Madnessvia/LumiSync/hw/hw.ip_user_files/bd/hdmi/ip/hdmi_auto_rs_w_0/hdmi_auto_rs_w_0_sim_netlist.v

// Copyright 1986-2020 Xilinx, Inc. All Rights Reserved.
// --------------------------------------------------------------------------------
// Tool Version: Vivado v.2020.1 (win64) Build 2902540 Wed May 27 19:54:49 MDT 2020
// Date        : Sun Mar  9 00:44:12 2025
// Host        : DESKTOP-E9C4J7R running 64-bit major release  (build 9200)
// Command     : write_verilog -force -mode funcsim -rename_top hdmi_auto_rs_w_0 -prefix
//               hdmi_auto_rs_w_0_ hdmi_auto_rs_w_0_sim_netlist.v
// Design      : hdmi_auto_rs_w_0
// Purpose     : This verilog netlist is a functional simulation representation of the design and should not be modified
//               or synthesized. This netlist cannot be used for SDF annotated simulation.
// Device      : xc7a200tsbg484-1
// --------------------------------------------------------------------------------
`timescale 1 ps / 1 ps

(* C_AXI_ADDR_WIDTH = "29" *) (* C_AXI_ARUSER_WIDTH = "1" *) (* C_AXI_AWUSER_WIDTH = "1" *) 
(* C_AXI_BUSER_WIDTH = "1" *) (* C_AXI_DATA_WIDTH = "256" *) (* C_AXI_ID_WIDTH = "2" *) 
(* C_AXI_PROTOCOL = "0" *) (* C_AXI_RUSER_WIDTH = "1" *) (* C_AXI_SUPPORTS_REGION_SIGNALS = "1" *) 
(* C_AXI_SUPPORTS_USER_SIGNALS = "0" *) (* C_AXI_WUSER_WIDTH = "1" *) (* C_FAMILY = "artix7" *) 
(* C_NUM_SLR_CROSSINGS = "0" *) (* C_PIPELINES_MASTER_AR = "0" *) (* C_PIPELINES_MASTER_AW = "0" *) 
(* C_PIPELINES_MASTER_B = "0" *) (* C_PIPELINES_MASTER_R = "0" *) (* C_PIPELINES_MASTER_W = "0" *) 
(* C_PIPELINES_MIDDLE_AR = "0" *) (* C_PIPELINES_MIDDLE_AW = "0" *) (* C_PIPELINES_MIDDLE_B = "0" *) 
(* C_PIPELINES_MIDDLE_R = "0" *) (* C_PIPELINES_MIDDLE_W = "0" *) (* C_PIPELINES_SLAVE_AR = "0" *) 
(* C_PIPELINES_SLAVE_AW = "0" *) (* C_PIPELINES_SLAVE_B = "0" *) (* C_PIPELINES_SLAVE_R = "0" *) 
(* C_PIPELINES_SLAVE_W = "0" *) (* C_REG_CONFIG_AR = "0" *) (* C_REG_CONFIG_AW = "0" *) 
(* C_REG_CONFIG_B = "0" *) (* C_REG_CONFIG_R = "0" *) (* C_REG_CONFIG_W = "1" *) 
(* C_RESERVE_MODE = "0" *) (* DowngradeIPIdentifiedWarnings = "yes" *) (* G_AXI_ARADDR_INDEX = "0" *) 
(* G_AXI_ARADDR_WIDTH = "29" *) (* G_AXI_ARBURST_INDEX = "35" *) (* G_AXI_ARBURST_WIDTH = "2" *) 
(* G_AXI_ARCACHE_INDEX = "37" *) (* G_AXI_ARCACHE_WIDTH = "4" *) (* G_AXI_ARID_INDEX = "50" *) 
(* G_AXI_ARID_WIDTH = "2" *) (* G_AXI_ARLEN_INDEX = "41" *) (* G_AXI_ARLEN_WIDTH = "8" *) 
(* G_AXI_ARLOCK_INDEX = "49" *) (* G_AXI_ARLOCK_WIDTH = "1" *) (* G_AXI_ARPAYLOAD_WIDTH = "60" *) 
(* G_AXI_ARPROT_INDEX = "29" *) (* G_AXI_ARPROT_WIDTH = "3" *) (* G_AXI_ARQOS_INDEX = "52" *) 
(* G_AXI_ARQOS_WIDTH = "4" *) (* G_AXI_ARREGION_INDEX = "56" *) (* G_AXI_ARREGION_WIDTH = "4" *) 
(* G_AXI_ARSIZE_INDEX = "32" *) (* G_AXI_ARSIZE_WIDTH = "3" *) (* G_AXI_ARUSER_INDEX = "60" *) 
(* G_AXI_ARUSER_WIDTH = "0" *) (* G_AXI_AWADDR_INDEX = "0" *) (* G_AXI_AWADDR_WIDTH = "29" *) 
(* G_AXI_AWBURST_INDEX = "35" *) (* G_AXI_AWBURST_WIDTH = "2" *) (* G_AXI_AWCACHE_INDEX = "37" *) 
(* G_AXI_AWCACHE_WIDTH = "4" *) (* G_AXI_AWID_INDEX = "50" *) (* G_AXI_AWID_WIDTH = "2" *) 
(* G_AXI_AWLEN_INDEX = "41" *) (* G_AXI_AWLEN_WIDTH = "8" *) (* G_AXI_AWLOCK_INDEX = "49" *) 
(* G_AXI_AWLOCK_WIDTH = "1" *) (* G_AXI_AWPAYLOAD_WIDTH = "60" *) (* G_AXI_AWPROT_INDEX = "29" *) 
(* G_AXI_AWPROT_WIDTH = "3" *) (* G_AXI_AWQOS_INDEX = "52" *) (* G_AXI_AWQOS_WIDTH = "4" *) 
(* G_AXI_AWREGION_INDEX = "56" *) (* G_AXI_AWREGION_WIDTH = "4" *) (* G_AXI_AWSIZE_INDEX = "32" *) 
(* G_AXI_AWSIZE_WIDTH = "3" *) (* G_AXI_AWUSER_INDEX = "60" *) (* G_AXI_AWUSER_WIDTH = "0" *) 
(* G_AXI_BID_INDEX = "2" *) (* G_AXI_BID_WIDTH = "2" *) (* G_AXI_BPAYLOAD_WIDTH = "4" *) 
(* G_AXI_BRESP_INDEX = "0" *) (* G_AXI_BRESP_WIDTH = "2" *) (* G_AXI_BUSER_INDEX = "4" *) 
(* G_AXI_BUSER_WIDTH = "0" *) (* G_AXI_RDATA_INDEX = "0" *) (* G_AXI_RDATA_WIDTH = "256" *) 
(* G_AXI_RID_INDEX = "259" *) (* G_AXI_RID_WIDTH = "2" *) (* G_AXI_RLAST_INDEX = "258" *) 
(* G_AXI_RLAST_WIDTH = "1" *) (* G_AXI_RPAYLOAD_WIDTH = "261" *) (* G_AXI_RRESP_INDEX = "256" *) 
(* G_AXI_RRESP_WIDTH = "2" *) (* G_AXI_RUSER_INDEX = "261" *) (* G_AXI_RUSER_WIDTH = "0" *) 
(* G_AXI_WDATA_INDEX = "0" *) (* G_AXI_WDATA_WIDTH = "256" *) (* G_AXI_WID_INDEX = "289" *) 
(* G_AXI_WID_WIDTH = "0" *) (* G_AXI_WLAST_INDEX = "288" *) (* G_AXI_WLAST_WIDTH = "1" *) 
(* G_AXI_WPAYLOAD_WIDTH = "289" *) (* G_AXI_WSTRB_INDEX = "256" *) (* G_AXI_WSTRB_WIDTH = "32" *) 
(* G_AXI_WUSER_INDEX = "289" *) (* G_AXI_WUSER_WIDTH = "0" *) (* P_FORWARD = "0" *) 
(* P_RESPONSE = "1" *) 
module hdmi_auto_rs_w_0_axi_register_slice_v2_1_21_axi_register_slice
   (aclk,
    aclk2x,
    aresetn,
    s_axi_awid,
    s_axi_awaddr,
    s_axi_awlen,
    s_axi_awsize,
    s_axi_awburst,
    s_axi_awlock,
    s_axi_awcache,
    s_axi_awprot,
    s_axi_awregion,
    s_axi_awqos,
    s_axi_awuser,
    s_axi_awvalid,
    s_axi_awready,
    s_axi_wid,
    s_axi_wdata,
    s_axi_wstrb,
    s_axi_wlast,
    s_axi_wuser,
    s_axi_wvalid,
    s_axi_wready,
    s_axi_bid,
    s_axi_bresp,
    s_axi_buser,
    s_axi_bvalid,
    s_axi_bready,
    s_axi_arid,
    s_axi_araddr,
    s_axi_arlen,
    s_axi_arsize,
    s_axi_arburst,
    s_axi_arlock,
    s_axi_arcache,
    s_axi_arprot,
    s_axi_arregion,
    s_axi_arqos,
    s_axi_aruser,
    s_axi_arvalid,
    s_axi_arready,
    s_axi_rid,
    s_axi_rdata,
    s_axi_rresp,
    s_axi_rlast,
    s_axi_ruser,
    s_axi_rvalid,
    s_axi_rready,
    m_axi_awid,
    m_axi_awaddr,
    m_axi_awlen,
    m_axi_awsize,
    m_axi_awburst,
    m_axi_awlock,
    m_axi_awcache,
    m_axi_awprot,
    m_axi_awregion,
    m_axi_awqos,
    m_axi_awuser,
    m_axi_awvalid,
    m_axi_awready,
    m_axi_wid,
    m_axi_wdata,
    m_axi_wstrb,
    m_axi_wlast,
    m_axi_wuser,
    m_axi_wvalid,
    m_axi_wready,
    m_axi_bid,
    m_axi_bresp,
    m_axi_buser,
    m_axi_bvalid,
    m_axi_bready,
    m_axi_arid,
    m_axi_araddr,
    m_axi_arlen,
    m_axi_arsize,
    m_axi_arburst,
    m_axi_arlock,
    m_axi_arcache,
    m_axi_arprot,
    m_axi_arregion,
    m_axi_arqos,
    m_axi_aruser,
    m_axi_arvalid,
    m_axi_arready,
    m_axi_rid,
    m_axi_rdata,
    m_axi_rresp,
    m_axi_rlast,
    m_axi_ruser,
    m_axi_rvalid,
    m_axi_rready);
  input aclk;
  input aclk2x;
  input aresetn;
  input [1:0]s_axi_awid;
  input [28:0]s_axi_awaddr;
  input [7:0]s_axi_awlen;
  input [2:0]s_axi_awsize;
  input [1:0]s_axi_awburst;
  input [0:0]s_axi_awlock;
  input [3:0]s_axi_awcache;
  input [2:0]s_axi_awprot;
  input [3:0]s_axi_awregion;
  input [3:0]s_axi_awqos;
  input [0:0]s_axi_awuser;
  input s_axi_awvalid;
  output s_axi_awready;
  input [1:0]s_axi_wid;
  input [255:0]s_axi_wdata;
  input [31:0]s_axi_wstrb;
  input s_axi_wlast;
  input [0:0]s_axi_wuser;
  input s_axi_wvalid;
  output s_axi_wready;
  output [1:0]s_axi_bid;
  output [1:0]s_axi_bresp;
  output [0:0]s_axi_buser;
  output s_axi_bvalid;
  input s_axi_bready;
  input [1:0]s_axi_arid;
  input [28:0]s_axi_araddr;
  input [7:0]s_axi_arlen;
  input [2:0]s_axi_arsize;
  input [1:0]s_axi_arburst;
  input [0:0]s_axi_arlock;
  input [3:0]s_axi_arcache;
  input [2:0]s_axi_arprot;
  input [3:0]s_axi_arregion;
  input [3:0]s_axi_arqos;
  input [0:0]s_axi_aruser;
  input s_axi_arvalid;
  output s_axi_arready;
  output [1:0]s_axi_rid;
  output [255:0]s_axi_rdata;
  output [1:0]s_axi_rresp;
  output s_axi_rlast;
  output [0:0]s_axi_ruser;
  output s_axi_rvalid;
  input s_axi_rready;
  output [1:0]m_axi_awid;
  output [28:0]m_axi_awaddr;
  output [7:0]m_axi_awlen;
  output [2:0]m_axi_awsize;
  output [1:0]m_axi_awburst;
  output [0:0]m_axi_awlock;
  output [3:0]m_axi_awcache;
  output [2:0]m_axi_awprot;
  output [3:0]m_axi_awregion;
  output [3:0]m_axi_awqos;
  output [0:0]m_axi_awuser;
  output m_axi_awvalid;
  input m_axi_awready;
  output [1:0]m_axi_wid;
  output [255:0]m_axi_wdata;
  output [31:0]m_axi_wstrb;
  output m_axi_wlast;
  output [0:0]m_axi_wuser;
  output m_axi_wvalid;
  input m_axi_wready;
  input [1:0]m_axi_bid;
  input [1:0]m_axi_bresp;
  input [0:0]m_axi_buser;
  input m_axi_bvalid;
  output m_axi_bready;
  output [1:0]m_axi_arid;
  output [28:0]m_axi_araddr;
  output [7:0]m_axi_arlen;
  output [2:0]m_axi_arsize;
  output [1:0]m_axi_arburst;
  output [0:0]m_axi_arlock;
  output [3:0]m_axi_arcache;
  output [2:0]m_axi_arprot;
  output [3:0]m_axi_arregion;
  output [3:0]m_axi_arqos;
  output [0:0]m_axi_aruser;
  output m_axi_arvalid;
  input m_axi_arready;
  input [1:0]m_axi_rid;
  input [255:0]m_axi_rdata;
  input [1:0]m_axi_rresp;
  input m_axi_rlast;
  input [0:0]m_axi_ruser;
  input m_axi_rvalid;
  output m_axi_rready;

  wire \<const0> ;
  wire aclk;
  wire aresetn;
  wire m_axi_arready;
  wire m_axi_awready;
  wire [1:0]m_axi_bid;
  wire [1:0]m_axi_bresp;
  wire m_axi_bvalid;
  wire [255:0]m_axi_rdata;
  wire [1:0]m_axi_rid;
  wire m_axi_rlast;
  wire [1:0]m_axi_rresp;
  wire m_axi_rvalid;
  wire [255:0]m_axi_wdata;
  wire m_axi_wlast;
  wire m_axi_wready;
  wire [31:0]m_axi_wstrb;
  wire m_axi_wvalid;
  wire [28:0]s_axi_araddr;
  wire [1:0]s_axi_arburst;
  wire [3:0]s_axi_arcache;
  wire [1:0]s_axi_arid;
  wire [7:0]s_axi_arlen;
  wire [0:0]s_axi_arlock;
  wire [2:0]s_axi_arprot;
  wire [3:0]s_axi_arqos;
  wire [3:0]s_axi_arregion;
  wire [2:0]s_axi_arsize;
  wire s_axi_arvalid;
  wire [28:0]s_axi_awaddr;
  wire [1:0]s_axi_awburst;
  wire [3:0]s_axi_awcache;
  wire [1:0]s_axi_awid;
  wire [7:0]s_axi_awlen;
  wire [0:0]s_axi_awlock;
  wire [2:0]s_axi_awprot;
  wire [3:0]s_axi_awqos;
  wire [3:0]s_axi_awregion;
  wire [2:0]s_axi_awsize;
  wire s_axi_awvalid;
  wire s_axi_bready;
  wire s_axi_rready;
  wire [255:0]s_axi_wdata;
  wire s_axi_wlast;
  wire s_axi_wready;
  wire [31:0]s_axi_wstrb;
  wire s_axi_wvalid;

  assign m_axi_araddr[28:0] = s_axi_araddr;
  assign m_axi_arburst[1:0] = s_axi_arburst;
  assign m_axi_arcache[3:0] = s_axi_arcache;
  assign m_axi_arid[1:0] = s_axi_arid;
  assign m_axi_arlen[7:0] = s_axi_arlen;
  assign m_axi_arlock[0] = s_axi_arlock;
  assign m_axi_arprot[2:0] = s_axi_arprot;
  assign m_axi_arqos[3:0] = s_axi_arqos;
  assign m_axi_arregion[3:0] = s_axi_arregion;
  assign m_axi_arsize[2:0] = s_axi_arsize;
  assign m_axi_aruser[0] = \<const0> ;
  assign m_axi_arvalid = s_axi_arvalid;
  assign m_axi_awaddr[28:0] = s_axi_awaddr;
  assign m_axi_awburst[1:0] = s_axi_awburst;
  assign m_axi_awcache[3:0] = s_axi_awcache;
  assign m_axi_awid[1:0] = s_axi_awid;
  assign m_axi_awlen[7:0] = s_axi_awlen;
  assign m_axi_awlock[0] = s_axi_awlock;
  assign m_axi_awprot[2:0] = s_axi_awprot;
  assign m_axi_awqos[3:0] = s_axi_awqos;
  assign m_axi_awregion[3:0] = s_axi_awregion;
  assign m_axi_awsize[2:0] = s_axi_awsize;
  assign m_axi_awuser[0] = \<const0> ;
  assign m_axi_awvalid = s_axi_awvalid;
  assign m_axi_bready = s_axi_bready;
  assign m_axi_rready = s_axi_rready;
  assign m_axi_wid[1] = \<const0> ;
  assign m_axi_wid[0] = \<const0> ;
  assign m_axi_wuser[0] = \<const0> ;
  assign s_axi_arready = m_axi_arready;
  assign s_axi_awready = m_axi_awready;
  assign s_axi_bid[1:0] = m_axi_bid;
  assign s_axi_bresp[1:0] = m_axi_bresp;
  assign s_axi_buser[0] = \<const0> ;
  assign s_axi_bvalid = m_axi_bvalid;
  assign s_axi_rdata[255:0] = m_axi_rdata;
  assign s_axi_rid[1:0] = m_axi_rid;
  assign s_axi_rlast = m_axi_rlast;
  assign s_axi_rresp[1:0] = m_axi_rresp;
  assign s_axi_ruser[0] = \<const0> ;
  assign s_axi_rvalid = m_axi_rvalid;
  GND GND
       (.G(\<const0> ));
  hdmi_auto_rs_w_0_axi_register_slice_v2_1_21_axic_register_slice__parameterized0 \w.w_pipe 
       (.Q({m_axi_wlast,m_axi_wstrb,m_axi_wdata}),
        .aclk(aclk),
        .aresetn(aresetn),
        .m_axi_wready(m_axi_wready),
        .m_valid_i_reg_0(m_axi_wvalid),
        .s_axi_wdata(s_axi_wdata),
        .s_axi_wlast(s_axi_wlast),
        .s_axi_wstrb(s_axi_wstrb),
        .s_axi_wvalid(s_axi_wvalid),
        .s_ready_i_reg_0(s_axi_wready));
endmodule

(* ORIG_REF_NAME = "axi_register_slice_v2_1_21_axic_register_slice" *) 
module hdmi_auto_rs_w_0_axi_register_slice_v2_1_21_axic_register_slice__parameterized0
   (m_valid_i_reg_0,
    s_ready_i_reg_0,
    Q,
    aclk,
    m_axi_wready,
    s_axi_wvalid,
    aresetn,
    s_axi_wlast,
    s_axi_wstrb,
    s_axi_wdata);
  output m_valid_i_reg_0;
  output s_ready_i_reg_0;
  output [288:0]Q;
  input aclk;
  input m_axi_wready;
  input s_axi_wvalid;
  input aresetn;
  input s_axi_wlast;
  input [31:0]s_axi_wstrb;
  input [255:0]s_axi_wdata;

  wire [288:0]Q;
  wire aclk;
  wire aresetn;
  wire \aresetn_d[1]_i_1_n_0 ;
  wire \aresetn_d_reg_n_0_[0] ;
  wire \aresetn_d_reg_n_0_[1] ;
  wire m_axi_wready;
  wire m_valid_i_i_1_n_0;
  wire m_valid_i_reg_0;
  wire p_1_in;
  wire [255:0]s_axi_wdata;
  wire s_axi_wlast;
  wire [31:0]s_axi_wstrb;
  wire s_axi_wvalid;
  wire s_ready_i_i_1_n_0;
  wire s_ready_i_reg_0;
  wire [288:0]skid_buffer;
  wire \skid_buffer_reg_n_0_[0] ;
  wire \skid_buffer_reg_n_0_[100] ;
  wire \skid_buffer_reg_n_0_[101] ;
  wire \skid_buffer_reg_n_0_[102] ;
  wire \skid_buffer_reg_n_0_[103] ;
  wire \skid_buffer_reg_n_0_[104] ;
  wire \skid_buffer_reg_n_0_[105] ;
  wire \skid_buffer_reg_n_0_[106] ;
  wire \skid_buffer_reg_n_0_[107] ;
  wire \skid_buffer_reg_n_0_[108] ;
  wire \skid_buffer_reg_n_0_[109] ;
  wire \skid_buffer_reg_n_0_[10] ;
  wire \skid_buffer_reg_n_0_[110] ;
  wire \skid_buffer_reg_n_0_[111] ;
  wire \skid_buffer_reg_n_0_[112] ;
  wire \skid_buffer_reg_n_0_[113] ;
  wire \skid_buffer_reg_n_0_[114] ;
  wire \skid_buffer_reg_n_0_[115] ;
  wire \skid_buffer_reg_n_0_[116] ;
  wire \skid_buffer_reg_n_0_[117] ;
  wire \skid_buffer_reg_n_0_[118] ;
  wire \skid_buffer_reg_n_0_[119] ;
  wire \skid_buffer_reg_n_0_[11] ;
  wire \skid_buffer_reg_n_0_[120] ;
  wire \skid_buffer_reg_n_0_[121] ;
  wire \skid_buffer_reg_n_0_[122] ;
  wire \skid_buffer_reg_n_0_[123] ;
  wire \skid_buffer_reg_n_0_[124] ;
  wire \skid_buffer_reg_n_0_[125] ;
  wire \skid_buffer_reg_n_0_[126] ;
  wire \skid_buffer_reg_n_0_[127] ;
  wire \skid_buffer_reg_n_0_[128] ;
  wire \skid_buffer_reg_n_0_[129] ;
  wire \skid_buffer_reg_n_0_[12] ;
  wire \skid_buffer_reg_n_0_[130] ;
  wire \skid_buffer_reg_n_0_[131] ;
  wire \skid_buffer_reg_n_0_[132] ;
  wire \skid_buffer_reg_n_0_[133] ;
  wire \skid_buffer_reg_n_0_[134] ;
  wire \skid_buffer_reg_n_0_[135] ;
  wire \skid_buffer_reg_n_0_[136] ;
  wire \skid_buffer_reg_n_0_[137] ;
  wire \skid_buffer_reg_n_0_[138] ;
  wire \skid_buffer_reg_n_0_[139] ;
  wire \skid_buffer_reg_n_0_[13] ;
  wire \skid_buffer_reg_n_0_[140] ;
  wire \skid_buffer_reg_n_0_[141] ;
  wire \skid_buffer_reg_n_0_[142] ;
  wire \skid_buffer_reg_n_0_[143] ;
  wire \skid_buffer_reg_n_0_[144] ;
  wire \skid_buffer_reg_n_0_[145] ;
  wire \skid_buffer_reg_n_0_[146] ;
  wire \skid_buffer_reg_n_0_[147] ;
  wire \skid_buffer_reg_n_0_[148] ;
  wire \skid_buffer_reg_n_0_[149] ;
  wire \skid_buffer_reg_n_0_[14] ;
  wire \skid_buffer_reg_n_0_[150] ;
  wire \skid_buffer_reg_n_0_[151] ;
  wire \skid_buffer_reg_n_0_[152] ;
  wire \skid_buffer_reg_n_0_[153] ;
  wire \skid_buffer_reg_n_0_[154] ;
  wire \skid_buffer_reg_n_0_[155] ;
  wire \skid_buffer_reg_n_0_[156] ;
  wire \skid_buffer_reg_n_0_[157] ;
  wire \skid_buffer_reg_n_0_[158] ;
  wire \skid_buffer_reg_n_0_[159] ;
  wire \skid_buffer_reg_n_0_[15] ;
  wire \skid_buffer_reg_n_0_[160] ;
  wire \skid_buffer_reg_n_0_[161] ;
  wire \skid_buffer_reg_n_0_[162] ;
  wire \skid_buffer_reg_n_0_[163] ;
  wire \skid_buffer_reg_n_0_[164] ;
  wire \skid_buffer_reg_n_0_[165] ;
  wire \skid_buffer_reg_n_0_[166] ;
  wire \skid_buffer_reg_n_0_[167] ;
  wire \skid_buffer_reg_n_0_[168] ;
  wire \skid_buffer_reg_n_0_[169] ;
  wire \skid_buffer_reg_n_0_[16] ;
  wire \skid_buffer_reg_n_0_[170] ;
  wire \skid_buffer_reg_n_0_[171] ;
  wire \skid_buffer_reg_n_0_[172] ;
  wire \skid_buffer_reg_n_0_[173] ;
  wire \skid_buffer_reg_n_0_[174] ;
  wire \skid_buffer_reg_n_0_[175] ;
  wire \skid_buffer_reg_n_0_[176] ;
  wire \skid_buffer_reg_n_0_[177] ;
  wire \skid_buffer_reg_n_0_[178] ;
  wire \skid_buffer_reg_n_0_[179] ;
  wire \skid_buffer_reg_n_0_[17] ;
  wire \skid_buffer_reg_n_0_[180] ;
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
        .CE(p_1_in),
        .D(skid_buffer[36]),
        .Q(Q[36]),
        .R(1'b0));
  FDRE \m_payload_i_reg[37] 
       (.C(aclk),
        .CE(p_1_in),
        .D(skid_buffer[37]),
        .Q(Q[37]),
        .R(1'b0));
  FDRE \m_payload_i_reg[38] 
       (.C(aclk),
        .CE(p_1_in),
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
