Madnessvia/LumiSync/hw/hw.ip_user_files/bd/hdmi/ip/hdmi_auto_rs_w_0/hdmi_auto_rs_w_0_sim_netlist.vhdl

-- Copyright 1986-2020 Xilinx, Inc. All Rights Reserved.
-- --------------------------------------------------------------------------------
-- Tool Version: Vivado v.2020.1 (win64) Build 2902540 Wed May 27 19:54:49 MDT 2020
-- Date        : Sun Mar  9 00:44:13 2025
-- Host        : DESKTOP-E9C4J7R running 64-bit major release  (build 9200)
-- Command     : write_vhdl -force -mode funcsim -rename_top hdmi_auto_rs_w_0 -prefix
--               hdmi_auto_rs_w_0_ hdmi_auto_rs_w_0_sim_netlist.vhdl
-- Design      : hdmi_auto_rs_w_0
-- Purpose     : This VHDL netlist is a functional simulation representation of the design and should not be modified or
--               synthesized. This netlist cannot be used for SDF annotated simulation.
-- Device      : xc7a200tsbg484-1
-- --------------------------------------------------------------------------------
library IEEE;
use IEEE.STD_LOGIC_1164.ALL;
library UNISIM;
use UNISIM.VCOMPONENTS.ALL;
entity \hdmi_auto_rs_w_0_axi_register_slice_v2_1_21_axic_register_slice__parameterized0\ is
  port (
    m_valid_i_reg_0 : out STD_LOGIC;
    s_ready_i_reg_0 : out STD_LOGIC;
    Q : out STD_LOGIC_VECTOR ( 288 downto 0 );
    aclk : in STD_LOGIC;
    m_axi_wready : in STD_LOGIC;
    s_axi_wvalid : in STD_LOGIC;
    aresetn : in STD_LOGIC;
    s_axi_wlast : in STD_LOGIC;
    s_axi_wstrb : in STD_LOGIC_VECTOR ( 31 downto 0 );
    s_axi_wdata : in STD_LOGIC_VECTOR ( 255 downto 0 )
  );
  attribute ORIG_REF_NAME : string;
  attribute ORIG_REF_NAME of \hdmi_auto_rs_w_0_axi_register_slice_v2_1_21_axic_register_slice__parameterized0\ : entity is "axi_register_slice_v2_1_21_axic_register_slice";
end \hdmi_auto_rs_w_0_axi_register_slice_v2_1_21_axic_register_slice__parameterized0\;

architecture STRUCTURE of \hdmi_auto_rs_w_0_axi_register_slice_v2_1_21_axic_register_slice__parameterized0\ is
  signal \aresetn_d[1]_i_1_n_0\ : STD_LOGIC;
  signal \aresetn_d_reg_n_0_[0]\ : STD_LOGIC;
  signal \aresetn_d_reg_n_0_[1]\ : STD_LOGIC;
  signal m_valid_i_i_1_n_0 : STD_LOGIC;
  signal \^m_valid_i_reg_0\ : STD_LOGIC;
  signal p_1_in : STD_LOGIC;
  signal s_ready_i_i_1_n_0 : STD_LOGIC;
  signal \^s_ready_i_reg_0\ : STD_LOGIC;
  signal skid_buffer : STD_LOGIC_VECTOR ( 288 downto 0 );
  signal \skid_buffer_reg_n_0_[0]\ : STD_LOGIC;
  signal \skid_buffer_reg_n_0_[100]\ : STD_LOGIC;
  signal \skid_buffer_reg_n_0_[101]\ : STD_LOGIC;
  signal \skid_buffer_reg_n_0_[102]\ : STD_LOGIC;
  signal \skid_buffer_reg_n_0_[103]\ : STD_LOGIC;
  signal \skid_buffer_reg_n_0_[104]\ : STD_LOGIC;
  signal \skid_buffer_reg_n_0_[105]\ : STD_LOGIC;
  signal \skid_buffer_reg_n_0_[106]\ : STD_LOGIC;
  signal \skid_buffer_reg_n_0_[107]\ : STD_LOGIC;
  signal \skid_buffer_reg_n_0_[108]\ : STD_LOGIC;
  signal \skid_buffer_reg_n_0_[109]\ : STD_LOGIC;
  signal \skid_buffer_reg_n_0_[10]\ : STD_LOGIC;
  signal \skid_buffer_reg_n_0_[110]\ : STD_LOGIC;
  signal \skid_buffer_reg_n_0_[111]\ : STD_LOGIC;
  signal \skid_buffer_reg_n_0_[112]\ : STD_LOGIC;
  signal \skid_buffer_reg_n_0_[113]\ : STD_LOGIC;
  signal \skid_buffer_reg_n_0_[114]\ : STD_LOGIC;
  signal \skid_buffer_reg_n_0_[115]\ : STD_LOGIC;
  signal \skid_buffer_reg_n_0_[116]\ : STD_LOGIC;
  signal \skid_buffer_reg_n_0_[117]\ : STD_LOGIC;
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
  attribute SOFT_HLUTNM of \m_payload_i[77]_i_1\ : label is "soft_lutpair38";
  attribute SOFT_HLUTNM of \m_payload_i[78]_i_1\ : label is "soft_lutpair39";
  attribute SOFT_HLUTNM of \m_payload_i[79]_i_1\ : label is "soft_lutpair39";
  attribute SOFT_HLUTNM of \m_payload_i[7]_i_1\ : label is "soft_lutpair3";
  attribute SOFT_HLUTNM of \m_payload_i[80]_i_1\ : label is "soft_lutpair40";
  attribute SOFT_HLUTNM of \m_payload_i[81]_i_1\ : label is "soft_lutpair40";
  attribute SOFT_HLUTNM of \m_payload_i[82]_i_1\ : label is "soft_lutpair41";
  attribute SOFT_HLUTNM of \m_payload_i[83]_i_1\ : label is "soft_lutpair41";
  attribute SOFT_HLUTNM of \m_payload_i[84]_i_1\ : label is "soft_lutpair42";
  attribute SOFT_HLUTNM of \m_payload_i[85]_i_1\ : label is "soft_lutpair42";
  attribute SOFT_HLUTNM of \m_payload_i[86]_i_1\ : label is "soft_lutpair43";
  attribute SOFT_HLUTNM of \m_payload_i[87]_i_1\ : label is "soft_lutpair43";
  attribute SOFT_HLUTNM of \m_payload_i[88]_i_1\ : label is "soft_lutpair44";
  attribute SOFT_HLUTNM of \m_payload_i[89]_i_1\ : label is "soft_lutpair44";
  attribute SOFT_HLUTNM of \m_payload_i[8]_i_1\ : label is "soft_lutpair4";
  attribute SOFT_HLUTNM of \m_payload_i[90]_i_1\ : label is "soft_lutpair45";
  attribute SOFT_HLUTNM of \m_payload_i[91]_i_1\ : label is "soft_lutpair45";
  attribute SOFT_HLUTNM of \m_payload_i[92]_i_1\ : label is "soft_lutpair46";
  attribute SOFT_HLUTNM of \m_payload_i[93]_i_1\ : label is "soft_lutpair46";
  attribute SOFT_HLUTNM of \m_payload_i[94]_i_1\ : label is "soft_lutpair47";
  attribute SOFT_HLUTNM of \m_payload_i[95]_i_1\ : label is "soft_lutpair47";
  attribute SOFT_HLUTNM of \m_payload_i[96]_i_1\ : label is "soft_lutpair48";
  attribute SOFT_HLUTNM of \m_payload_i[97]_i_1\ : label is "soft_lutpair48";
  attribute SOFT_HLUTNM of \m_payload_i[98]_i_1\ : label is "soft_lutpair49";
  attribute SOFT_HLUTNM of \m_payload_i[99]_i_1\ : label is "soft_lutpair49";
  attribute SOFT_HLUTNM of \m_payload_i[9]_i_1\ : label is "soft_lutpair4";
begin
  m_valid_i_reg_0 <= \^m_valid_i_reg_0\;
  s_ready_i_reg_0 <= \^s_ready_i_reg_0\;
\aresetn_d[1]_i_1\: unisim.vcomponents.LUT2
    generic map(
      INIT => X"8"
    )
        port map (
      I0 => \aresetn_d_reg_n_0_[0]\,
      I1 => aresetn,
      O => \aresetn_d[1]_i_1_n_0\
    );
\aresetn_d_reg[0]\: unisim.vcomponents.FDRE
    generic map(
      INIT => '0'
    )
        port map (
      C => aclk,
      CE => '1',
      D => aresetn,
      Q => \aresetn_d_reg_n_0_[0]\,
      R => '0'
    );
\aresetn_d_reg[1]\: unisim.vcomponents.FDRE
    generic map(
      INIT => '0'
    )
        port map (
      C => aclk,
      CE => '1',
      D => \aresetn_d[1]_i_1_n_0\,
      Q => \aresetn_d_reg_n_0_[1]\,
      R => '0'
    );
\m_payload_i[0]_i_1\: unisim.vcomponents.LUT3
    generic map(
      INIT => X"AC"
    )
        port map (
      I0 => s_axi_wdata(0),
      I1 => \skid_buffer_reg_n_0_[0]\,
      I2 => \^s_ready_i_reg_0\,
      O => skid_buffer(0)
    );
\m_payload_i[100]_i_1\: unisim.vcomponents.LUT3
    generic map(
      INIT => X"AC"
    )
        port map (
      I0 => s_axi_wdata(100),
      I1 => \skid_buffer_reg_n_0_[100]\,
      I2 => \^s_ready_i_reg_0\,
      O => skid_buffer(100)
    );
\m_payload_i[101]_i_1\: unisim.vcomponents.LUT3
    generic map(
      INIT => X"AC"
    )
        port map (
      I0 => s_axi_wdata(101),
      I1 => \skid_buffer_reg_n_0_[101]\,
      I2 => \^s_ready_i_reg_0\,
      O => skid_buffer(101)
    );
\m_payload_i[102]_i_1\: unisim.vcomponents.LUT3
    generic map(
      INIT => X"AC"
    )
        port map (
      I0 => s_axi_wdata(102),
      I1 => \skid_buffer_reg_n_0_[102]\,
      I2 => \^s_ready_i_reg_0\,
      O => skid_buffer(102)
    );
\m_payload_i[103]_i_1\: unisim.vcomponents.LUT3
    generic map(
      INIT => X"AC"
    )
        port map (
      I0 => s_axi_wdata(103),
      I1 => \skid_buffer_reg_n_0_[103]\,
      I2 => \^s_ready_i_reg_0\,
      O => skid_buffer(103)
    );
\m_payload_i[104]_i_1\: unisim.vcomponents.LUT3
    generic map(
      INIT => X"AC"
    )
        port map (
      I0 => s_axi_wdata(104),
      I1 => \skid_buffer_reg_n_0_[104]\,
      I2 => \^s_ready_i_reg_0\,
      O => skid_buffer(104)
    );
\m_payload_i[105]_i_1\: unisim.vcomponents.LUT3
    generic map(
      INIT => X"AC"
    )
        port map (
      I0 => s_axi_wdata(105),
      I1 => \skid_buffer_reg_n_0_[105]\,
      I2 => \^s_ready_i_reg_0\,
      O => skid_buffer(105)
    );
\m_payload_i[106]_i_1\: unisim.vcomponents.LUT3
    generic map(
      INIT => X"AC"
    )
        port map (
      I0 => s_axi_wdata(106),
      I1 => \skid_buffer_reg_n_0_[106]\,
      I2 => \^s_ready_i_reg_0\,
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
     port map (
      C => aclk,
      CE => p_1_in,
      D => skid_buffer(143),
      Q => Q(143),
      R => '0'
    );
\m_payload_i_reg[144]\: unisim.vcomponents.FDRE
     port map (
      C => aclk,
      CE => p_1_in,
      D => skid_buffer(144),
      Q => Q(144),
      R => '0'
    );
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
