Madnessvia/LumiSync/hw/hw.ip_user_files/bd/hdmi/ip/hdmi_axi_gpio_video_0/hdmi_axi_gpio_video_0_sim_netlist.vhdl

-- Copyright 1986-2020 Xilinx, Inc. All Rights Reserved.
-- --------------------------------------------------------------------------------
-- Tool Version: Vivado v.2020.1 (win64) Build 2902540 Wed May 27 19:54:49 MDT 2020
-- Date        : Thu Oct 22 13:15:35 2020
-- Host        : WK142 running 64-bit major release  (build 9200)
-- Command     : write_vhdl -force -mode funcsim
--               d:/Github/Contractor/Nexys-Video/hdmi/Nexys-Video-HDMI/hw/proj/hw.srcs/sources_1/bd/hdmi/ip/hdmi_axi_gpio_video_0/hdmi_axi_gpio_video_0_sim_netlist.vhdl
-- Design      : hdmi_axi_gpio_video_0
-- Purpose     : This VHDL netlist is a functional simulation representation of the design and should not be modified or
--               synthesized. This netlist cannot be used for SDF annotated simulation.
-- Device      : xc7a200tsbg484-1
-- --------------------------------------------------------------------------------
library IEEE;
use IEEE.STD_LOGIC_1164.ALL;
library UNISIM;
use UNISIM.VCOMPONENTS.ALL;
entity hdmi_axi_gpio_video_0_address_decoder is
  port (
    \GEN_BKEND_CE_REGISTERS[14].ce_out_i_reg[14]_0\ : out STD_LOGIC;
    bus2ip_cs : out STD_LOGIC_VECTOR ( 0 to 0 );
    Bus_RNW_reg_reg_0 : out STD_LOGIC;
    D : out STD_LOGIC_VECTOR ( 3 downto 0 );
    irpt_rdack : out STD_LOGIC;
    intr2bus_rdack0 : out STD_LOGIC;
    irpt_wrack : out STD_LOGIC;
    interrupt_wrce_strb : out STD_LOGIC;
    irpt_wrack_d1_reg : out STD_LOGIC;
    ip2Bus_WrAck_intr_reg_hole0 : out STD_LOGIC;
    intr_rd_ce_or_reduce : out STD_LOGIC;
    ip2Bus_RdAck_intr_reg_hole0 : out STD_LOGIC;
    intr_wr_ce_or_reduce : out STD_LOGIC;
    \s_axi_wdata[31]\ : out STD_LOGIC;
    s_axi_wdata_0_sp_1 : out STD_LOGIC;
    \s_axi_wdata[0]_0\ : out STD_LOGIC;
    \s_axi_wdata[0]_1\ : out STD_LOGIC;
    \s_axi_wdata[0]_2\ : out STD_LOGIC;
    ip2bus_wrack_i_D1_reg : out STD_LOGIC;
    ip2bus_rdack_i_D1_reg : out STD_LOGIC;
    Q : in STD_LOGIC;
    s_axi_aclk : in STD_LOGIC;
    \MEM_DECODE_GEN[0].cs_out_i_reg[0]_0\ : in STD_LOGIC_VECTOR ( 6 downto 0 );
    ipif_glbl_irpt_enable_reg : in STD_LOGIC;
    irpt_rdack_d1 : in STD_LOGIC;
    irpt_wrack_d1 : in STD_LOGIC;
    ip2Bus_WrAck_intr_reg_hole_d1 : in STD_LOGIC;
    ip2Bus_RdAck_intr_reg_hole_d1 : in STD_LOGIC;
    p_1_in : in STD_LOGIC;
    p_0_in0_in : in STD_LOGIC;
    reg1 : in STD_LOGIC_VECTOR ( 0 to 0 );
    reg3 : in STD_LOGIC_VECTOR ( 0 to 0 );
    \ip2bus_data_i_D1_reg[31]\ : in STD_LOGIC;
    \ip2bus_data_i_D1_reg[31]_0\ : in STD_LOGIC;
    s_axi_wdata : in STD_LOGIC_VECTOR ( 1 downto 0 );
    \Dual.gpio2_OE_reg[0]\ : in STD_LOGIC;
    gpio2_io_t : in STD_LOGIC_VECTOR ( 0 to 0 );
    gpio_io_o : in STD_LOGIC_VECTOR ( 0 to 0 );
    gpio_io_t : in STD_LOGIC_VECTOR ( 0 to 0 );
    gpio2_io_o : in STD_LOGIC_VECTOR ( 0 to 0 );
    s_axi_aresetn : in STD_LOGIC;
    ip2bus_rdack_i_D1 : in STD_LOGIC;
    s_axi_arready : in STD_LOGIC;
    s_axi_arready_0 : in STD_LOGIC_VECTOR ( 3 downto 0 );
    ip2bus_wrack_i_D1 : in STD_LOGIC;
    s_axi_wready : in STD_LOGIC
  );
  attribute ORIG_REF_NAME : string;
  attribute ORIG_REF_NAME of hdmi_axi_gpio_video_0_address_decoder : entity is "address_decoder";
end hdmi_axi_gpio_video_0_address_decoder;

architecture STRUCTURE of hdmi_axi_gpio_video_0_address_decoder is
  signal Bus_RNW_reg_i_1_n_0 : STD_LOGIC;
  signal \^bus_rnw_reg_reg_0\ : STD_LOGIC;
  signal \^d\ : STD_LOGIC_VECTOR ( 3 downto 0 );
  signal \Dual.gpio_Data_Out[0]_i_2_n_0\ : STD_LOGIC;
  signal \Dual.gpio_OE[0]_i_2_n_0\ : STD_LOGIC;
  signal \^gen_bkend_ce_registers[14].ce_out_i_reg[14]_0\ : STD_LOGIC;
  signal \GEN_BKEND_CE_REGISTERS[19].ce_out_i_reg_n_0_[19]\ : STD_LOGIC;
  signal \INTR_CTRLR_GEN.ip2Bus_WrAck_intr_reg_hole_d1_i_2_n_0\ : STD_LOGIC;
  signal \INTR_CTRLR_GEN.ip2Bus_WrAck_intr_reg_hole_d1_i_3_n_0\ : STD_LOGIC;
  signal \INTR_CTRLR_GEN.ip2Bus_WrAck_intr_reg_hole_d1_i_4_n_0\ : STD_LOGIC;
  signal \^bus2ip_cs\ : STD_LOGIC_VECTOR ( 0 to 0 );
  signal ce_expnd_i_0 : STD_LOGIC;
  signal ce_expnd_i_1 : STD_LOGIC;
  signal ce_expnd_i_10 : STD_LOGIC;
  signal ce_expnd_i_11 : STD_LOGIC;
  signal ce_expnd_i_12 : STD_LOGIC;
  signal ce_expnd_i_13 : STD_LOGIC;
  signal ce_expnd_i_14 : STD_LOGIC;
  signal ce_expnd_i_15 : STD_LOGIC;
  signal ce_expnd_i_16 : STD_LOGIC;
  signal ce_expnd_i_17 : STD_LOGIC;
  signal ce_expnd_i_18 : STD_LOGIC;
  signal ce_expnd_i_19 : STD_LOGIC;
  signal ce_expnd_i_2 : STD_LOGIC;
  signal ce_expnd_i_3 : STD_LOGIC;
  signal ce_expnd_i_4 : STD_LOGIC;
  signal ce_expnd_i_5 : STD_LOGIC;
  signal ce_expnd_i_6 : STD_LOGIC;
  signal ce_expnd_i_7 : STD_LOGIC;
  signal ce_expnd_i_8 : STD_LOGIC;
  signal ce_expnd_i_9 : STD_LOGIC;
  signal cs_ce_clr : STD_LOGIC;
  signal \ip2bus_data_i_D1[31]_i_2_n_0\ : STD_LOGIC;
  signal \ip2bus_data_i_D1[31]_i_3_n_0\ : STD_LOGIC;
  signal \ip2bus_data_i_D1[31]_i_4_n_0\ : STD_LOGIC;
  signal \^ip2bus_rdack_i_d1_reg\ : STD_LOGIC;
  signal \^ip2bus_wrack_i_d1_reg\ : STD_LOGIC;
  signal p_10_in : STD_LOGIC;
  signal p_11_in : STD_LOGIC;
  signal p_12_in : STD_LOGIC;
  signal p_13_in : STD_LOGIC;
  signal p_14_in : STD_LOGIC;
  signal p_15_in : STD_LOGIC;
  signal p_16_in : STD_LOGIC;
  signal p_17_in : STD_LOGIC;
  signal p_18_in : STD_LOGIC;
  signal p_19_in : STD_LOGIC;
  signal p_1_in_0 : STD_LOGIC;
  signal p_2_in : STD_LOGIC;
  signal p_3_in : STD_LOGIC;
  signal p_4_in : STD_LOGIC;
  signal p_6_in : STD_LOGIC;
  signal p_7_in : STD_LOGIC;
  signal p_8_in : STD_LOGIC;
  signal p_9_in : STD_LOGIC;
  signal pselect_hit_i_1 : STD_LOGIC;
  signal s_axi_wdata_0_sn_1 : STD_LOGIC;
  attribute SOFT_HLUTNM : string;
  attribute SOFT_HLUTNM of Bus_RNW_reg_i_1 : label is "soft_lutpair16";
  attribute SOFT_HLUTNM of \Dual.gpio_Data_Out[0]_i_2\ : label is "soft_lutpair13";
  attribute SOFT_HLUTNM of \Dual.gpio_OE[0]_i_2\ : label is "soft_lutpair13";
  attribute SOFT_HLUTNM of \GEN_BKEND_CE_REGISTERS[0].ce_out_i[0]_i_1\ : label is "soft_lutpair14";
  attribute SOFT_HLUTNM of \GEN_BKEND_CE_REGISTERS[10].ce_out_i[10]_i_1\ : label is "soft_lutpair6";
  attribute SOFT_HLUTNM of \GEN_BKEND_CE_REGISTERS[11].ce_out_i[11]_i_1\ : label is "soft_lutpair6";
  attribute SOFT_HLUTNM of \GEN_BKEND_CE_REGISTERS[12].ce_out_i[12]_i_1\ : label is "soft_lutpair5";
  attribute SOFT_HLUTNM of \GEN_BKEND_CE_REGISTERS[13].ce_out_i[13]_i_1\ : label is "soft_lutpair5";
  attribute SOFT_HLUTNM of \GEN_BKEND_CE_REGISTERS[14].ce_out_i[14]_i_1\ : label is "soft_lutpair4";
  attribute SOFT_HLUTNM of \GEN_BKEND_CE_REGISTERS[15].ce_out_i[15]_i_1\ : label is "soft_lutpair4";
  attribute SOFT_HLUTNM of \GEN_BKEND_CE_REGISTERS[16].ce_out_i[16]_i_1\ : label is "soft_lutpair3";
  attribute SOFT_HLUTNM of \GEN_BKEND_CE_REGISTERS[17].ce_out_i[17]_i_1\ : label is "soft_lutpair3";
  attribute SOFT_HLUTNM of \GEN_BKEND_CE_REGISTERS[18].ce_out_i[18]_i_1\ : label is "soft_lutpair2";
  attribute SOFT_HLUTNM of \GEN_BKEND_CE_REGISTERS[19].ce_out_i[19]_i_2\ : label is "soft_lutpair2";
  attribute SOFT_HLUTNM of \GEN_BKEND_CE_REGISTERS[1].ce_out_i[1]_i_1\ : label is "soft_lutpair15";
  attribute SOFT_HLUTNM of \GEN_BKEND_CE_REGISTERS[2].ce_out_i[2]_i_1\ : label is "soft_lutpair14";
  attribute SOFT_HLUTNM of \GEN_BKEND_CE_REGISTERS[3].ce_out_i[3]_i_1\ : label is "soft_lutpair15";
  attribute SOFT_HLUTNM of \GEN_BKEND_CE_REGISTERS[4].ce_out_i[4]_i_1\ : label is "soft_lutpair9";
  attribute SOFT_HLUTNM of \GEN_BKEND_CE_REGISTERS[5].ce_out_i[5]_i_1\ : label is "soft_lutpair9";
  attribute SOFT_HLUTNM of \GEN_BKEND_CE_REGISTERS[6].ce_out_i[6]_i_1\ : label is "soft_lutpair8";
  attribute SOFT_HLUTNM of \GEN_BKEND_CE_REGISTERS[7].ce_out_i[7]_i_1\ : label is "soft_lutpair8";
  attribute SOFT_HLUTNM of \GEN_BKEND_CE_REGISTERS[8].ce_out_i[8]_i_1\ : label is "soft_lutpair7";
  attribute SOFT_HLUTNM of \GEN_BKEND_CE_REGISTERS[9].ce_out_i[9]_i_1\ : label is "soft_lutpair7";
  attribute SOFT_HLUTNM of \GEN_IP_IRPT_STATUS_REG[0].GEN_REG_STATUS.ip_irpt_status_reg[0]_i_2\ : label is "soft_lutpair12";
  attribute SOFT_HLUTNM of \INTR_CTRLR_GEN.ip2Bus_RdAck_intr_reg_hole_d1_i_1\ : label is "soft_lutpair0";
  attribute SOFT_HLUTNM of \INTR_CTRLR_GEN.ip2Bus_RdAck_intr_reg_hole_i_1\ : label is "soft_lutpair1";
  attribute SOFT_HLUTNM of \INTR_CTRLR_GEN.ip2Bus_WrAck_intr_reg_hole_d1_i_1\ : label is "soft_lutpair1";
  attribute SOFT_HLUTNM of \INTR_CTRLR_GEN.ip2Bus_WrAck_intr_reg_hole_i_1\ : label is "soft_lutpair0";
  attribute SOFT_HLUTNM of intr2bus_rdack_i_1 : label is "soft_lutpair10";
  attribute SOFT_HLUTNM of intr2bus_wrack_i_1 : label is "soft_lutpair11";
  attribute SOFT_HLUTNM of \ip2bus_data_i_D1[31]_i_3\ : label is "soft_lutpair16";
  attribute SOFT_HLUTNM of \ip2bus_data_i_D1[31]_i_4\ : label is "soft_lutpair12";
  attribute SOFT_HLUTNM of irpt_rdack_d1_i_1 : label is "soft_lutpair10";
  attribute SOFT_HLUTNM of irpt_wrack_d1_i_1 : label is "soft_lutpair11";
begin
  Bus_RNW_reg_reg_0 <= \^bus_rnw_reg_reg_0\;
  D(3 downto 0) <= \^d\(3 downto 0);
  \GEN_BKEND_CE_REGISTERS[14].ce_out_i_reg[14]_0\ <= \^gen_bkend_ce_registers[14].ce_out_i_reg[14]_0\;
  bus2ip_cs(0) <= \^bus2ip_cs\(0);
  ip2bus_rdack_i_D1_reg <= \^ip2bus_rdack_i_d1_reg\;
  ip2bus_wrack_i_D1_reg <= \^ip2bus_wrack_i_d1_reg\;
  s_axi_wdata_0_sp_1 <= s_axi_wdata_0_sn_1;
Bus_RNW_reg_i_1: unisim.vcomponents.LUT3
    generic map(
      INIT => X"B8"
    )
        port map (
      I0 => \Dual.gpio2_OE_reg[0]\,
      I1 => Q,
      I2 => \^bus_rnw_reg_reg_0\,
      O => Bus_RNW_reg_i_1_n_0
    );
Bus_RNW_reg_reg: unisim.vcomponents.FDRE
     port map (
      C => s_axi_aclk,
      CE => '1',
      D => Bus_RNW_reg_i_1_n_0,
      Q => \^bus_rnw_reg_reg_0\,
      R => '0'
    );
\Dual.gpio2_Data_Out[0]_i_1\: unisim.vcomponents.LUT5
    generic map(
      INIT => X"FFBF0080"
    )
        port map (
      I0 => s_axi_wdata(0),
      I1 => \MEM_DECODE_GEN[0].cs_out_i_reg[0]_0\(1),
      I2 => \Dual.gpio_Data_Out[0]_i_2_n_0\,
      I3 => \Dual.gpio2_OE_reg[0]\,
      I4 => gpio2_io_o(0),
      O => \s_axi_wdata[0]_2\
    );
\Dual.gpio2_OE[0]_i_1\: unisim.vcomponents.LUT5
    generic map(
      INIT => X"FFBF0080"
    )
        port map (
      I0 => s_axi_wdata(0),
      I1 => \MEM_DECODE_GEN[0].cs_out_i_reg[0]_0\(1),
      I2 => \Dual.gpio_OE[0]_i_2_n_0\,
      I3 => \Dual.gpio2_OE_reg[0]\,
      I4 => gpio2_io_t(0),
      O => s_axi_wdata_0_sn_1
    );
\Dual.gpio_Data_Out[0]_i_1\: unisim.vcomponents.LUT5
    generic map(
      INIT => X"FFEF0020"
    )
        port map (
      I0 => s_axi_wdata(0),
      I1 => \MEM_DECODE_GEN[0].cs_out_i_reg[0]_0\(1),
      I2 => \Dual.gpio_Data_Out[0]_i_2_n_0\,
      I3 => \Dual.gpio2_OE_reg[0]\,
      I4 => gpio_io_o(0),
      O => \s_axi_wdata[0]_0\
    );
\Dual.gpio_Data_Out[0]_i_2\: unisim.vcomponents.LUT3
    generic map(
      INIT => X"04"
    )
        port map (
      I0 => \MEM_DECODE_GEN[0].cs_out_i_reg[0]_0\(6),
      I1 => \^bus2ip_cs\(0),
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
